raptorofaxys/clvc/KiCAD/VentilatorMotherboard/CANVent schematic.pdf

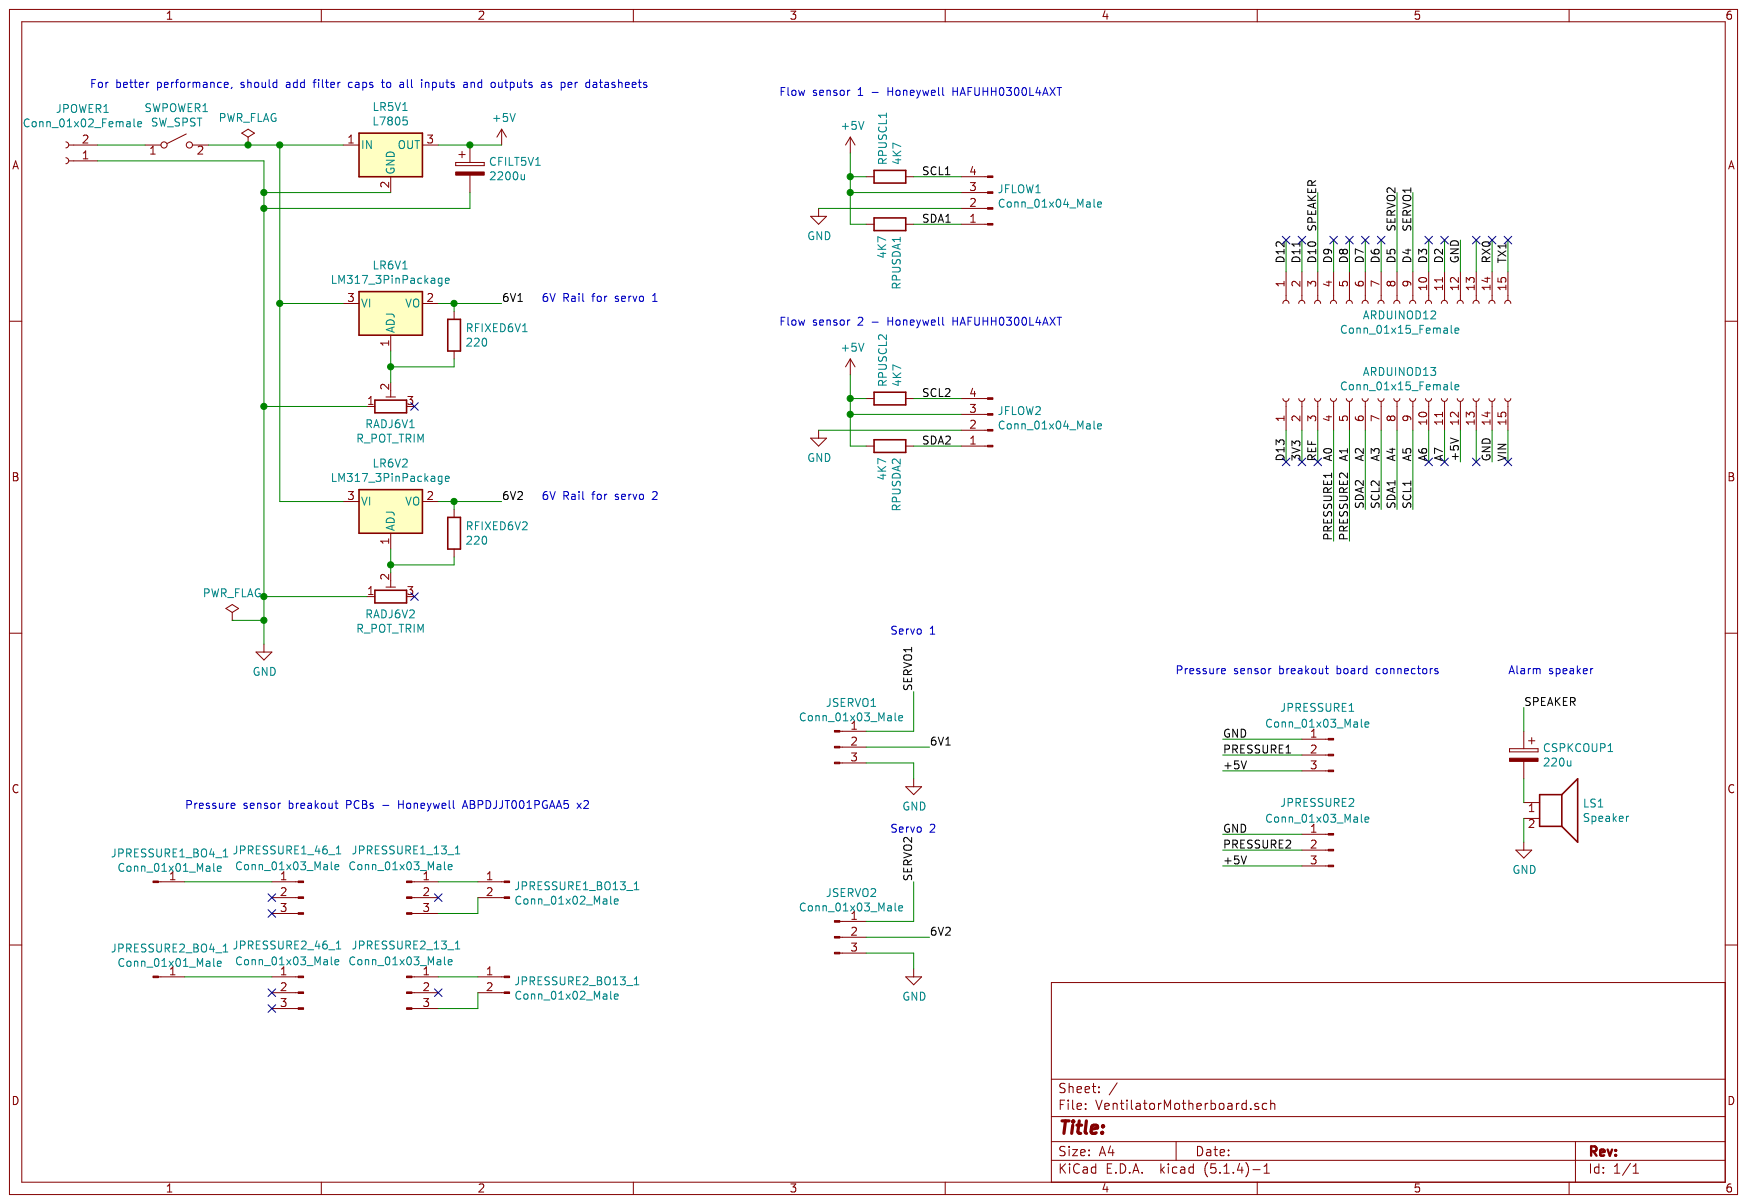
[picture p1: page 1]
