raptorofaxys/clvc/KiCAD/VentilatorMotherboard/CANVent PCB.pdf

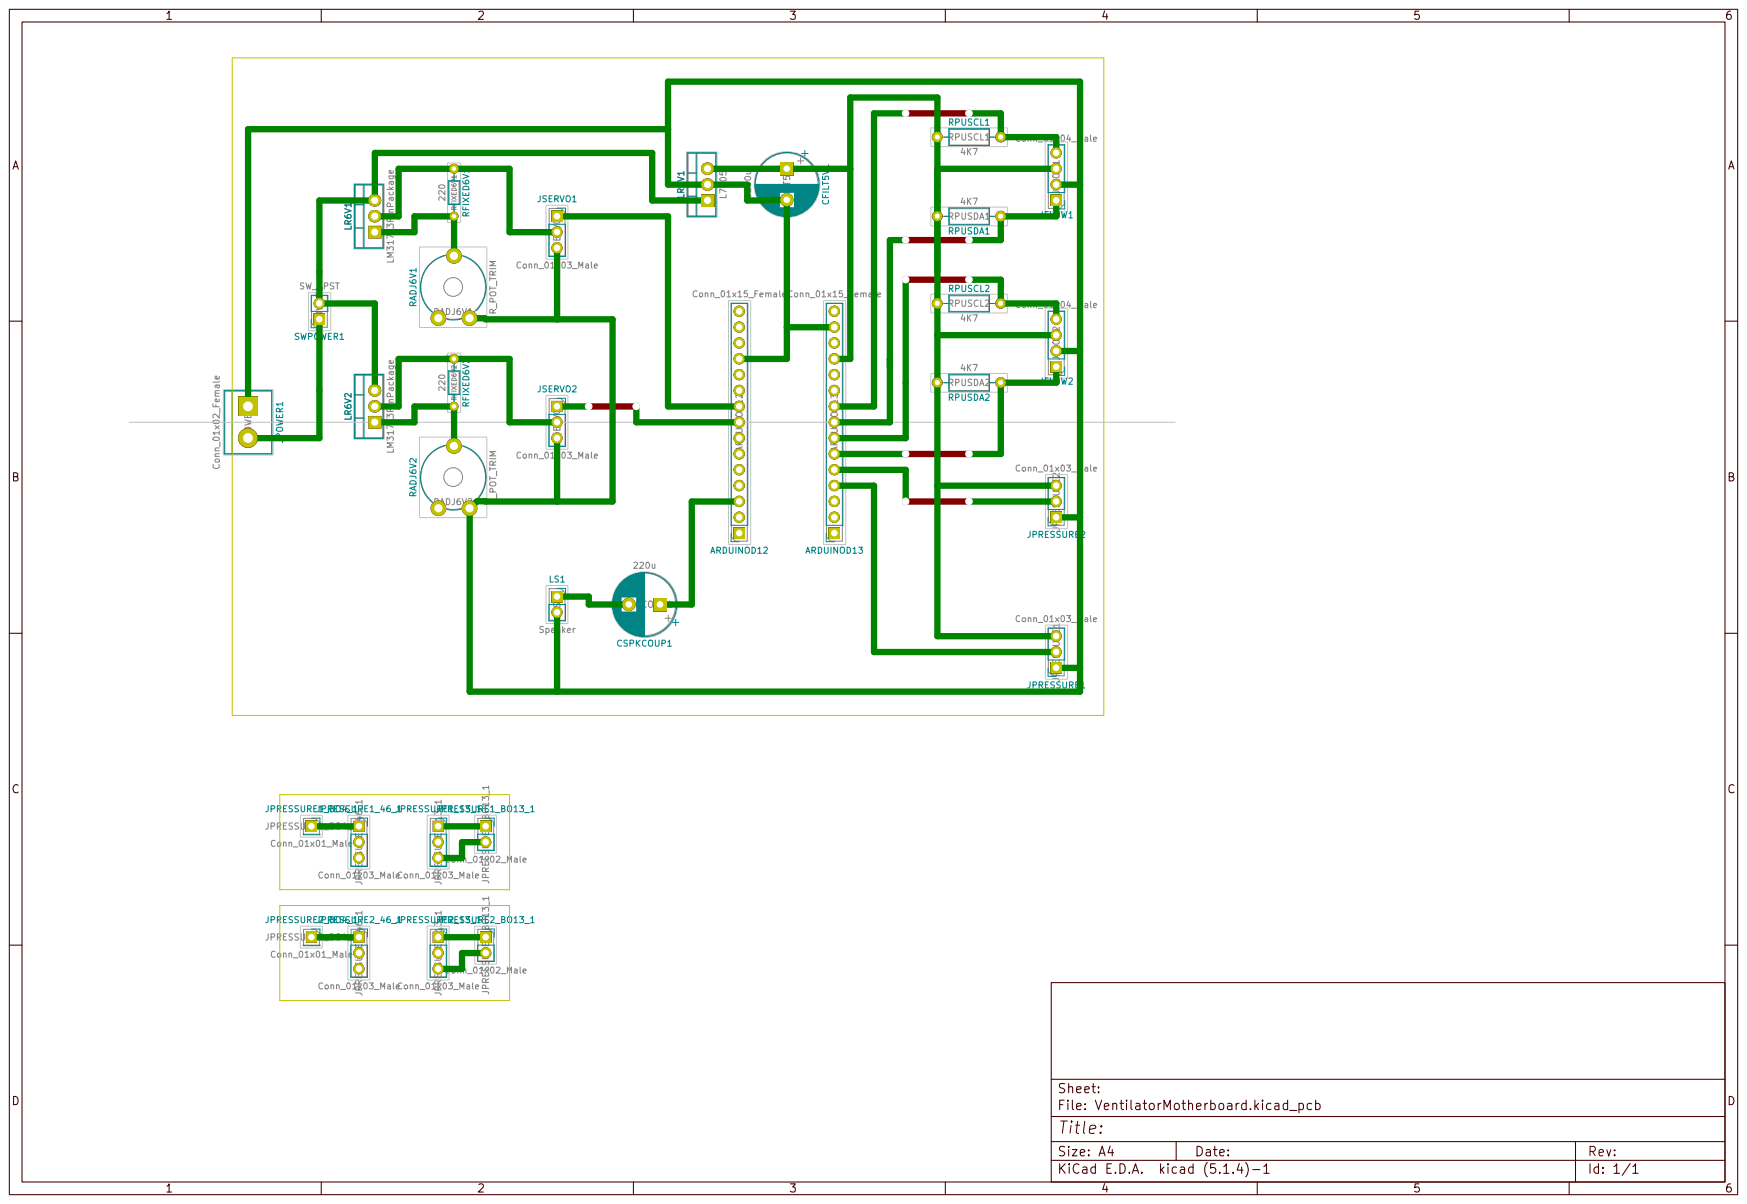
[picture p2: page 1]
