raptorofaxys/clvc/KiCAD/VentilatorMotherboard/PDF/VentilatorMotherboard-B_Cu.pdf

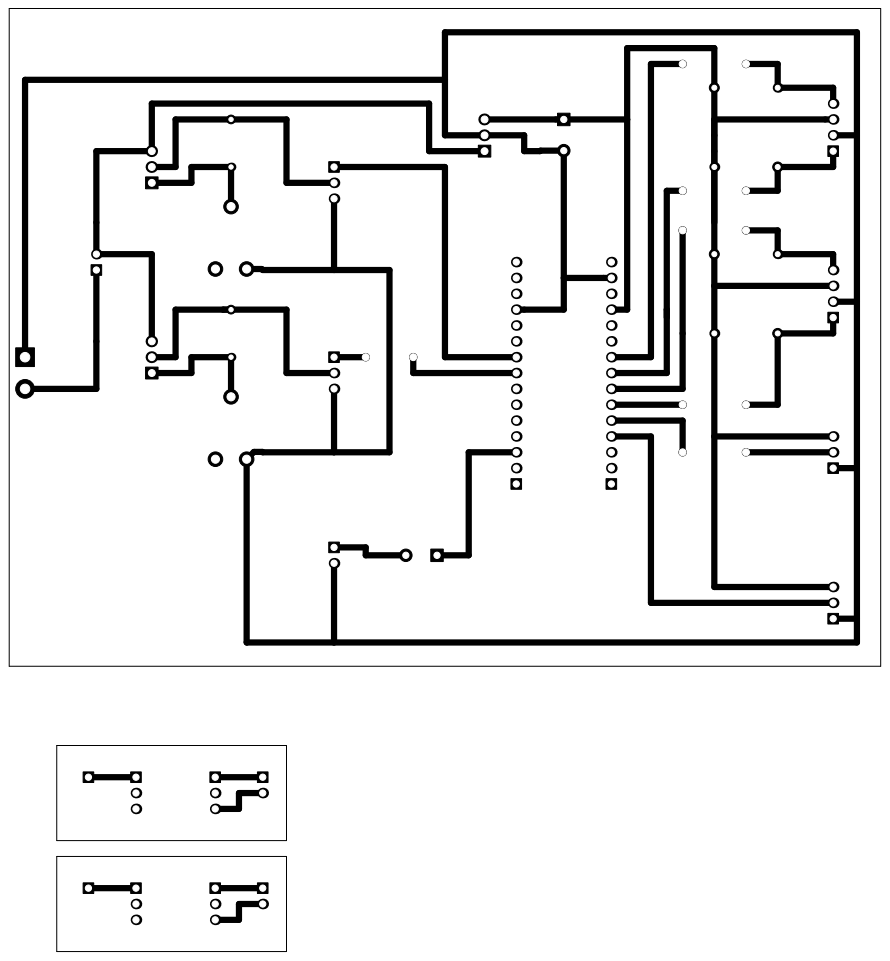
[picture p3: page 1]
