raptorofaxys/clvc/KiCAD/VentilatorMotherboard/PDF/VentilatorMotherboard-F_Cu.pdf

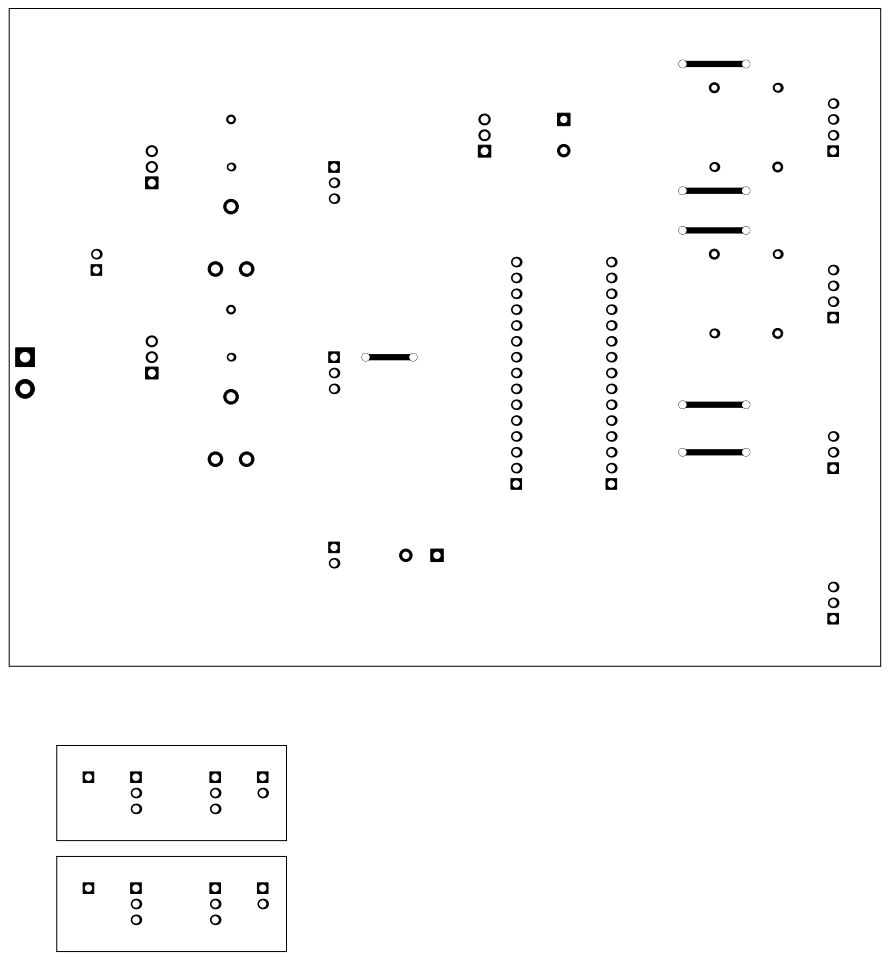
[picture p4: page 1]
