raptorofaxys/clvc/KiCAD/VentilatorMotherboard/VentilatorMotherboard.kicad_pcb

## KiCad design KiCAD/VentilatorMotherboard/VentilatorMotherboard.kicad_pcb (2020-04-07)

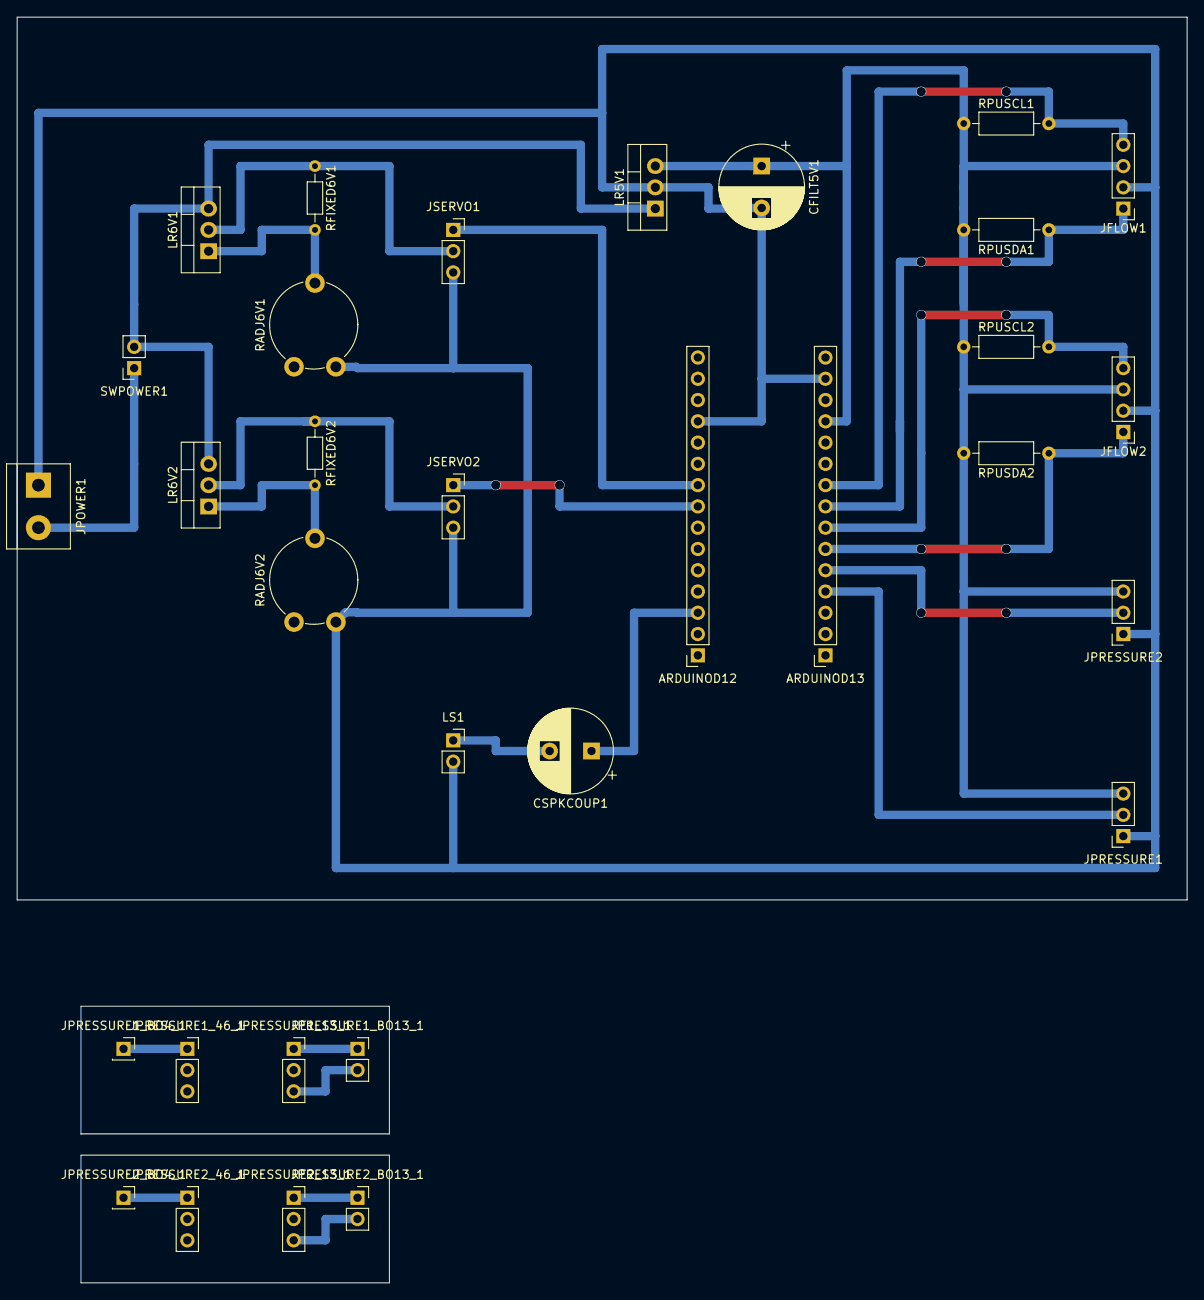
[picture p5: board VentilatorMotherboard.kicad_pcb from above]

Board: 2 copper layers, 139.7 x 151.1 mm, 32 parts (0 on the bottom side), 24 nets.

Parts:
ARDUINOD12, ARDUINOD13: Conn_01x15_Female; PinSocket_1x15_P2.54mm_Vertical
CFILT5V1: 2200u; CP_Radial_D10.0mm_P5.00mm
CSPKCOUP1: 220u; CP_Radial_D10.0mm_P5.00mm
JFLOW1, JFLOW2: Conn_01x04_Male; PinHeader_1x04_P2.54mm_Vertical
JPOWER1: Conn_01x02_Female; TerminalBlock_bornier-2_P5.08mm
JPRESSURE1, JPRESSURE1_13_1, JPRESSURE1_46_1, JPRESSURE2, JPRESSURE2_13_1, JPRESSURE2_46_1: Conn_01x03_Male; PinSocket_1x03_P2.54mm_Vertical
JPRESSURE1_BO4_1, JPRESSURE2_BO4_1: Conn_01x01_Male; PinSocket_1x01_P2.54mm_Vertical
JPRESSURE1_BO13_1, JPRESSURE2_BO13_1: Conn_01x02_Male; PinSocket_1x02_P2.54mm_Vertical
JSERVO1, JSERVO2: Conn_01x03_Male; PinSocket_1x03_P2.54mm_Vertical
LR5V1: L7805; TO-220-3_Vertical
LR6V1, LR6V2: LM317_3PinPackage; TO-220-3_Vertical
LS1: Speaker; PinSocket_1x02_P2.54mm_Vertical
RADJ6V1, RADJ6V2: R_POT_TRIM; Potentiometer_Piher_PT-10-V10_Vertical
RFIXED6V1, RFIXED6V2: 220; R_Axial_DIN0204_L3.6mm_D1.6mm_P7.62mm_Horizontal
RPUSCL1, RPUSCL2: 4K7; R_Axial_DIN0207_L6.3mm_D2.5mm_P10.16mm_Horizontal
RPUSDA1, RPUSDA2: 4K7; R_Axial_DIN0207_L6.3mm_D2.5mm_P10.16mm_Horizontal
SWPOWER1: SW_SPST; PinSocket_1x02_P2.54mm_Vertical

Connections:
+5V: ARDUINOD13.12, CFILT5V1.1, JFLOW1.3, JFLOW2.3, JPRESSURE1.3, JPRESSURE2.3, LR5V1.3, RPUSCL1.1, RPUSCL2.1, RPUSDA1.2, RPUSDA2.2
/6V1: JSERVO1.2, LR6V1.2, RFIXED6V1.1
/6V2: JSERVO2.2, LR6V2.2, RFIXED6V2.1
/A0: ARDUINOD13.4, JPRESSURE1.2
/A1: ARDUINOD13.5, JPRESSURE2.2
/A2: ARDUINOD13.6, JFLOW2.1, RPUSDA2.1
/A3: ARDUINOD13.7, JFLOW2.4, RPUSCL2.2
/A4: ARDUINOD13.8, JFLOW1.1, RPUSDA1.1
/A5: ARDUINOD13.9, JFLOW1.4, RPUSCL1.2
/D4: ARDUINOD12.9, JSERVO1.1
/D5: ARDUINOD12.8, JSERVO2.1
/D10: ARDUINOD12.3, CSPKCOUP1.1
GND: ARDUINOD12.12, ARDUINOD13.14, CFILT5V1.2, JFLOW1.2, JFLOW2.2, JPOWER1.1, JPRESSURE1.1, JPRESSURE2.1, JSERVO1.3, JSERVO2.3, LR5V1.2, LS1.2, RADJ6V1.1, RADJ6V2.1
unnamed: CSPKCOUP1.2, LS1.1
unnamed: JPOWER1.2, SWPOWER1.1
unnamed: JPRESSURE1_13_1.1, JPRESSURE1_BO13_1.1
unnamed: JPRESSURE1_13_1.3, JPRESSURE1_BO13_1.2
unnamed: JPRESSURE1_46_1.1, JPRESSURE1_BO4_1.1
unnamed: JPRESSURE2_13_1.1, JPRESSURE2_BO13_1.1
unnamed: JPRESSURE2_13_1.3, JPRESSURE2_BO13_1.2
unnamed: JPRESSURE2_46_1.1, JPRESSURE2_BO4_1.1
unnamed: LR5V1.1, LR6V1.3, LR6V2.3, SWPOWER1.2
unnamed: LR6V1.1, RADJ6V1.2, RFIXED6V1.2
unnamed: LR6V2.1, RADJ6V2.2, RFIXED6V2.2
