raptorofaxys/clvc/KiCAD/VentilatorPSU/VentilatorPSU.kicad_pcb

## KiCad design KiCAD/VentilatorPSU/VentilatorPSU.kicad_pcb (2020-03-27)

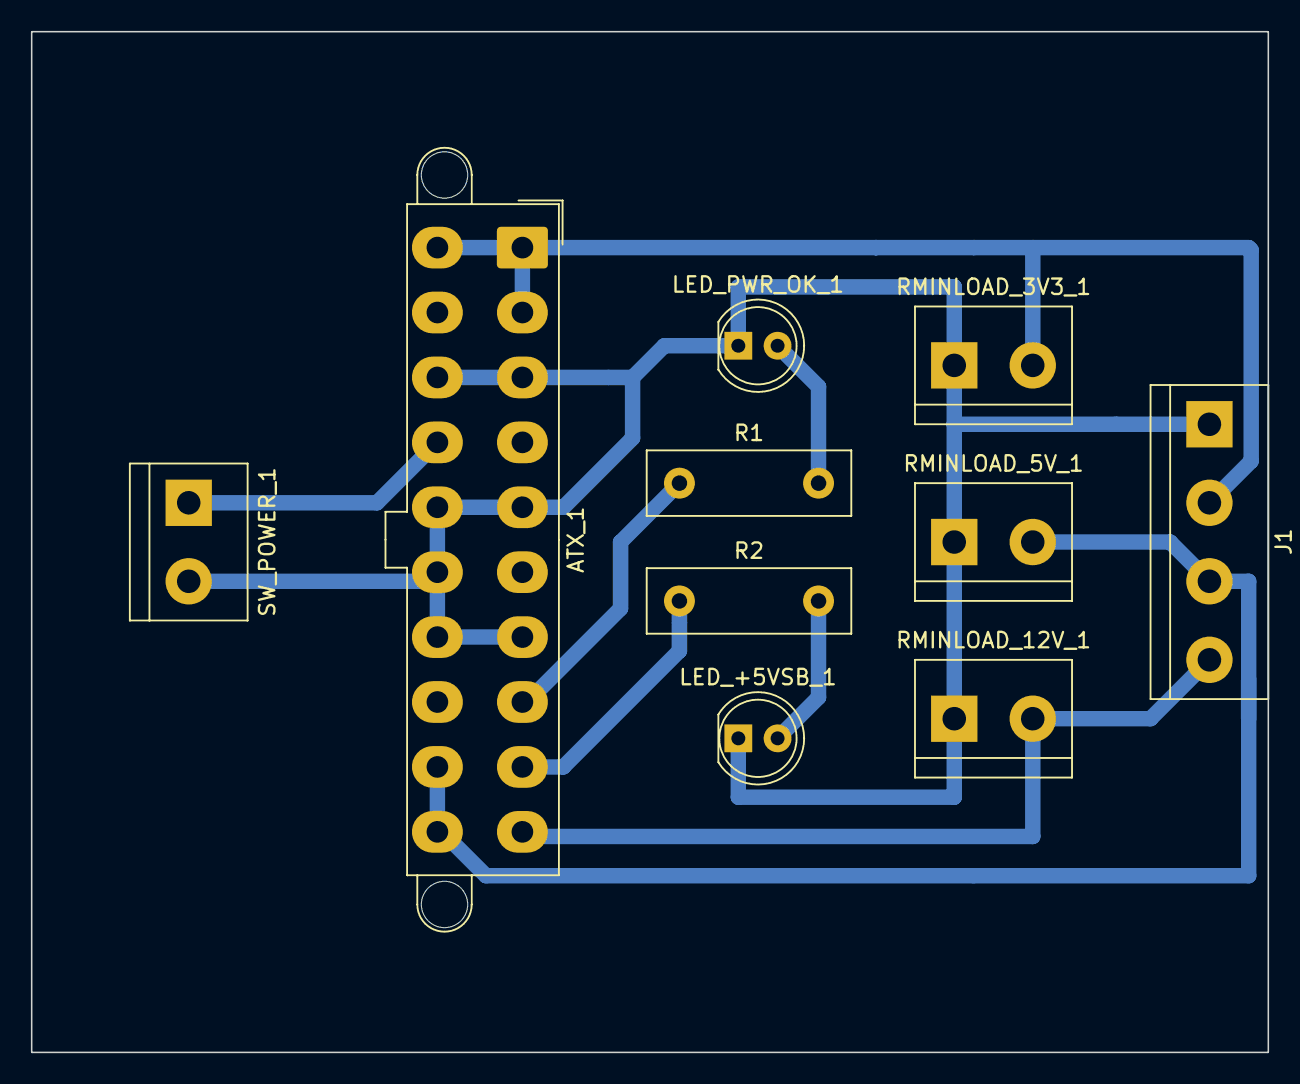
[picture p6: board VentilatorPSU.kicad_pcb from above]

Board: 2 copper layers, 80.0 x 66.0 mm, 10 parts (0 on the bottom side), 9 nets.

Parts:
ATX_1: Conn_02x10_Top_Bottom; Molex_Mini-Fit_Jr_5566-20A2_2x10_P4.20mm_Vertical
J1: Conn_01x04_Female; TerminalBlock_bornier-4_P5.08mm
LED_+5VSB_1: LED_+5VSB; LED_D5.0mm
LED_PWR_OK_1: LED_PWR_OK; LED_D5.0mm
R1, R2: 300; R_Box_L13.0mm_W4.0mm_P9.00mm
RMINLOAD_3V3_1: 5; TerminalBlock_bornier-2_P5.08mm
RMINLOAD_5V_1, RMINLOAD_12V_1: 10; TerminalBlock_bornier-2_P5.08mm
SW_POWER_1: SW_POWER; TerminalBlock_bornier-2_P5.08mm

Connections:
+3V3: ATX_1.1, ATX_1.2, ATX_1.11, J1.2, RMINLOAD_3V3_1.2
+5V: ATX_1.19, ATX_1.20, J1.3, RMINLOAD_5V_1.2
+12V: ATX_1.10, J1.4, RMINLOAD_12V_1.2
/+5VSB: ATX_1.9, R2.1
/PWR_OK: ATX_1.8, R1.1
/PWR_ON: ATX_1.14, SW_POWER_1.1
GND: ATX_1.3, ATX_1.5, ATX_1.7, ATX_1.13, ATX_1.15, ATX_1.16, ATX_1.17, J1.1, LED_+5VSB_1.1, LED_PWR_OK_1.1, RMINLOAD_3V3_1.1, RMINLOAD_5V_1.1, RMINLOAD_12V_1.1, SW_POWER_1.2
unnamed: LED_+5VSB_1.2, R2.2
unnamed: LED_PWR_OK_1.2, R1.2
