raptorofaxys/clvc/(commit log)

2020-03-27 Initial commit
    Interfaced:
    -speaker
    -servos
    -pressure sensors
    -hardware I2C flowmeter
    [COVentPSU.kicad_pcb, COVentPSU.sch]
2020-03-28 All sensors integrated
    Make the default number of float decimals configurable .
    Add PrintStringHex32.
    Flow sensor only reads when more than 1ms has elapsed.
    Flow sensor checks that device is reachable at start.
    Add humidity and temperature sensor logic.
    Make sensors and actuators individually toggleable at compilation level for debugging.
2020-03-29 Blink LED on D13 when a halt/assert occurs for easier debugging without a PC
2020-03-29 Add a temporary Arduino sketch we can use as a scratchpad to debug remotely
2020-03-29 Add motherboard KiCAD
    (also, rename a bunch of stuff to avoid naming conflicts)
    [VentilatorMotherboard.kicad_pcb, VentilatorMotherboard.sch, VentilatorPSU.kicad_pcb, VentilatorPSU.sch]
2020-03-29 Rename some directories to avoid naming conflicts
    [COVentArduino.ino, COVentArduinoPlayground.ino]
2020-03-29 Rename more files and make the playground sketch center the servos
2020-03-29 UI framework
2020-03-29 Zero the servos at one end of the range
2020-03-29 Adjust the servo sweeping motion in the playground
2020-03-29 Remove serial print from playground
2020-03-29 Arduino can send hashed structured messages to Processing
2020-03-29 Fixed graph running fade; Added graph circle on current value
    [UIGraph.pde]
2020-03-29 Processing can now send hash-verified messages to the Arduino
2020-03-30 UIGraph now has a public SetValue
    -Nicer fake graph values
    -Explicit frame rate
    -Resolution closer to target device size
    -Smooth = true
2020-03-30 Add low-pass filtering logic
2020-03-30 If the graph advances without having a new sample, hold the previous value
2020-03-30 Tracking message send/receive rates and reporting them to the UI
    Also:
    Add the basis for virtual sensors inputs.
2020-03-30 WIP trigger logic and error condition tracking
    [VentilatorArduino.ino, VentilatorProcessing.pde]
2020-03-30 Reduce the servo signal timing bounds a little to try to avoid an end-stick
    [VentilatorArduinoPlayground.ino]
2020-03-30 Make playground swing servos and display sensor state
2020-03-30 Correct servo swinging logic in playground
    [VentilatorArduinoPlayground.ino]
2020-03-30 Switch pressure units to cmH2O
2020-03-31 Add virtual pressure-controlled mode along with basic pressure virtual input simulation
    Add debug floats in machine state to help with debugging
2020-03-31 Mask target changes from error rate calculations to help stabilize controller; send updates every frame to prevent very strange behaviour that will no doubt become clear the moment I step away from t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
    [VentilatorArduino.ino, VentilatorProcessing.pde]
2020-03-31 Track peak pressure; display values from MCU on UI
2020-03-31 Track and display plateau pressure and PEEP
2020-03-31 More samples on graph; appDebug to control verbose
2020-03-31 Send values from UI to Arduino
2020-03-31 Track sensed PEEP across rest as well and lower minimum I:E ratio to 1.0
    Might get rid of the rest phase in the long run.
2020-03-31 Inspiratory pressure stacks on top of the PEEP
2020-03-31 Prevent NaNs in pressure trackers
    [VentilatorArduino.ino]
2020-03-31 The controller can now correct the inspiratory time on the UI side when it gets clamped because of breath rate settings
    [VentilatorArduino.ino, VentilatorProcessing.pde]
2020-03-31 Refactor pressure tracking code as a step towards plateau tracking
2020-03-31 Color the background of the pressure graph as a function of the breath phase
2020-03-31 Properly track inspiration plateau and peep plateau
2020-03-31 Make virtual lung inflate/deflate to model flow
2020-03-31 Make total system flow graph work
2020-04-01 Visual feedback on selection of Control Buttons
2020-04-01 Fix for touch screen PC
    [UIInteractiveElement.pde]
2020-04-01 Fixed Graph skips
    - Bumped strokeWeight to 1.5, issue was apparently line rasterizer
    - Converted every part of the calculation to float
    [UIGraph.pde]
2020-04-02 Graph background improvements
    -Graph marks on axis at every second
    -Graph background is fully drawn on init
    -Graph sample count matches 12 seconds of graph
    -Resolution 960x600, half of target screen
2020-04-06 Add power switch to PCB; add some text annotations
    [VentilatorMotherboard.kicad_pcb, VentilatorMotherboard.sch]
2020-04-06 Final submission docs etc.
    [VentilatorMotherboard.kicad_pcb]
2020-04-06 Initialize everything just to be sure - that _totalSeconds float in the pressure sensor for virtual input logic could likely have randomly caused NaNs
